EmbeddedMan/FBMiniLEDController/Board/FBMiniLEDController_v11/FBMiniLEDController_v1.1_2.jpg

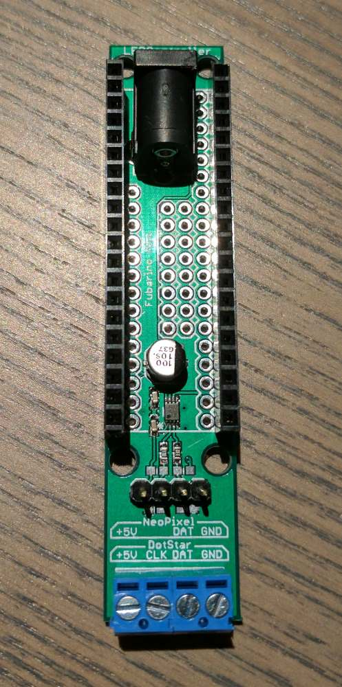
Board/FBMiniLEDController_v11/FBMiniLEDController_v1.1_2.jpg
