EmbeddedMan/FBMiniLEDController/README.md

# FBMiniLEDController
DotStar/NeoPixel controller board for Fubarino Mini chipKIT board
