EmbeddedMan/FBMiniLEDController/Board/FBMiniLEDController_v11/FBMiniLEDController_v11_BOM.xlsx

FBMiniLEDController v1.1 BOM
 |  | Lines in read are Do Not Populate!
Item # | Qty | Ref Des | Manufacturer | Mfg Part # | Dist. Part # | Description | Package | Type
1 | 2 | C1, C2 | Kemet | C0603C104K5RACTU | 399-5089-1-ND | CAP CERAMIC .100UF 50V X7R 0603 | 0603 | SMT
2 | 1 | J4 | CUI Inc. | PJ-202A | CP-202A-ND | Power Barrel Connector Jack 2.00mm ID (0.079"), 5.50mm OD (0.217") Through Hole, Right Angle | connector | through-hole
alt 2 | 1 | J4 |  |  |  | https://www.amazon.com/15PCS-Power-Socket-Barrel-Type-DC-005/dp/B00W944ACE | connector | through-hole
3 | 1 | S1 | C&K (https://www.digikey.com/en/supplier-centers/c/ck-components) | 1101M2S3AQE2 | CKN5006-ND | SWITCH SLIDE SPDT 6A 120V | switch | through-hole
alt 3 | 1 | S1 |  |  |  | https://www.aliexpress.com/store/product/SS-12D06-1P2T-handle-high-5MM-single-row-of-curved-foot-toggle-switch-10pcs-lot/2191027_32663392378.html | switch | through-hole
4 | 1 | U1 | Nexperia USA Inc. (https://www.digikey.com/en/supplier-centers/n/nexperia) | 74LVCH2T45DC,125 | 1727-4596-1-ND | TXRX TRANSLATING 3ST 8VSSOP | 8VSSOP | smt
5 | 1 | J3 | Phoenix Contact (https://www.digikey.com/en/supplier-centers/p/phoenix-contact) | 1984989 | 277-6404-ND | CONN TERM BLOCK 4POS 3.5MM | header | through-hole
6 | 1 | J7
7 | 2 | J8, J9
8 | 2 | J5, J6
9 | 2 | J1, J2 | Sullins Connector Solutions (https://www.digikey.com/en/supplier-centers/s/sullins-connector-solutions) | PPTC201LFBN-RC | S7018-ND | CONN HEADER FEMALE 20POS.1" TIN | header | through-hole
alt 9 | 2 | J1,J2 |  |  |  | https://www.amazon.com/uxcell-2-54mm-Single-Straight-Ardunio/dp/B013STKIH4
 |  |  |  |  |  | BOARD SUMMARY FOR QUOTE
 |  |  |  |  |  | Unique Part Count | 32
 |  |  |  |  |  | Total Placements | 266
 |  |  |  |  |  | Thru Hole Placements | 10
 |  |  |  |  |  | Has BGA Placements? | No
