EmbeddedMan/FBMiniLEDController/Board/FBMiniLEDController_v1/BOM.txt

Switch : EG2355-ND
  ALT: https://www.amazon.com/Gadgeter-Position-Terminal-Latching-Toggle/dp/B01JU6KBH6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
  
Level shifter : 1727-4596-1-ND
