EmbeddedMan/FBMiniLEDController/Board/FBMiniLEDController_v11/FBMiniLEDStrip_sch_v11.pdf

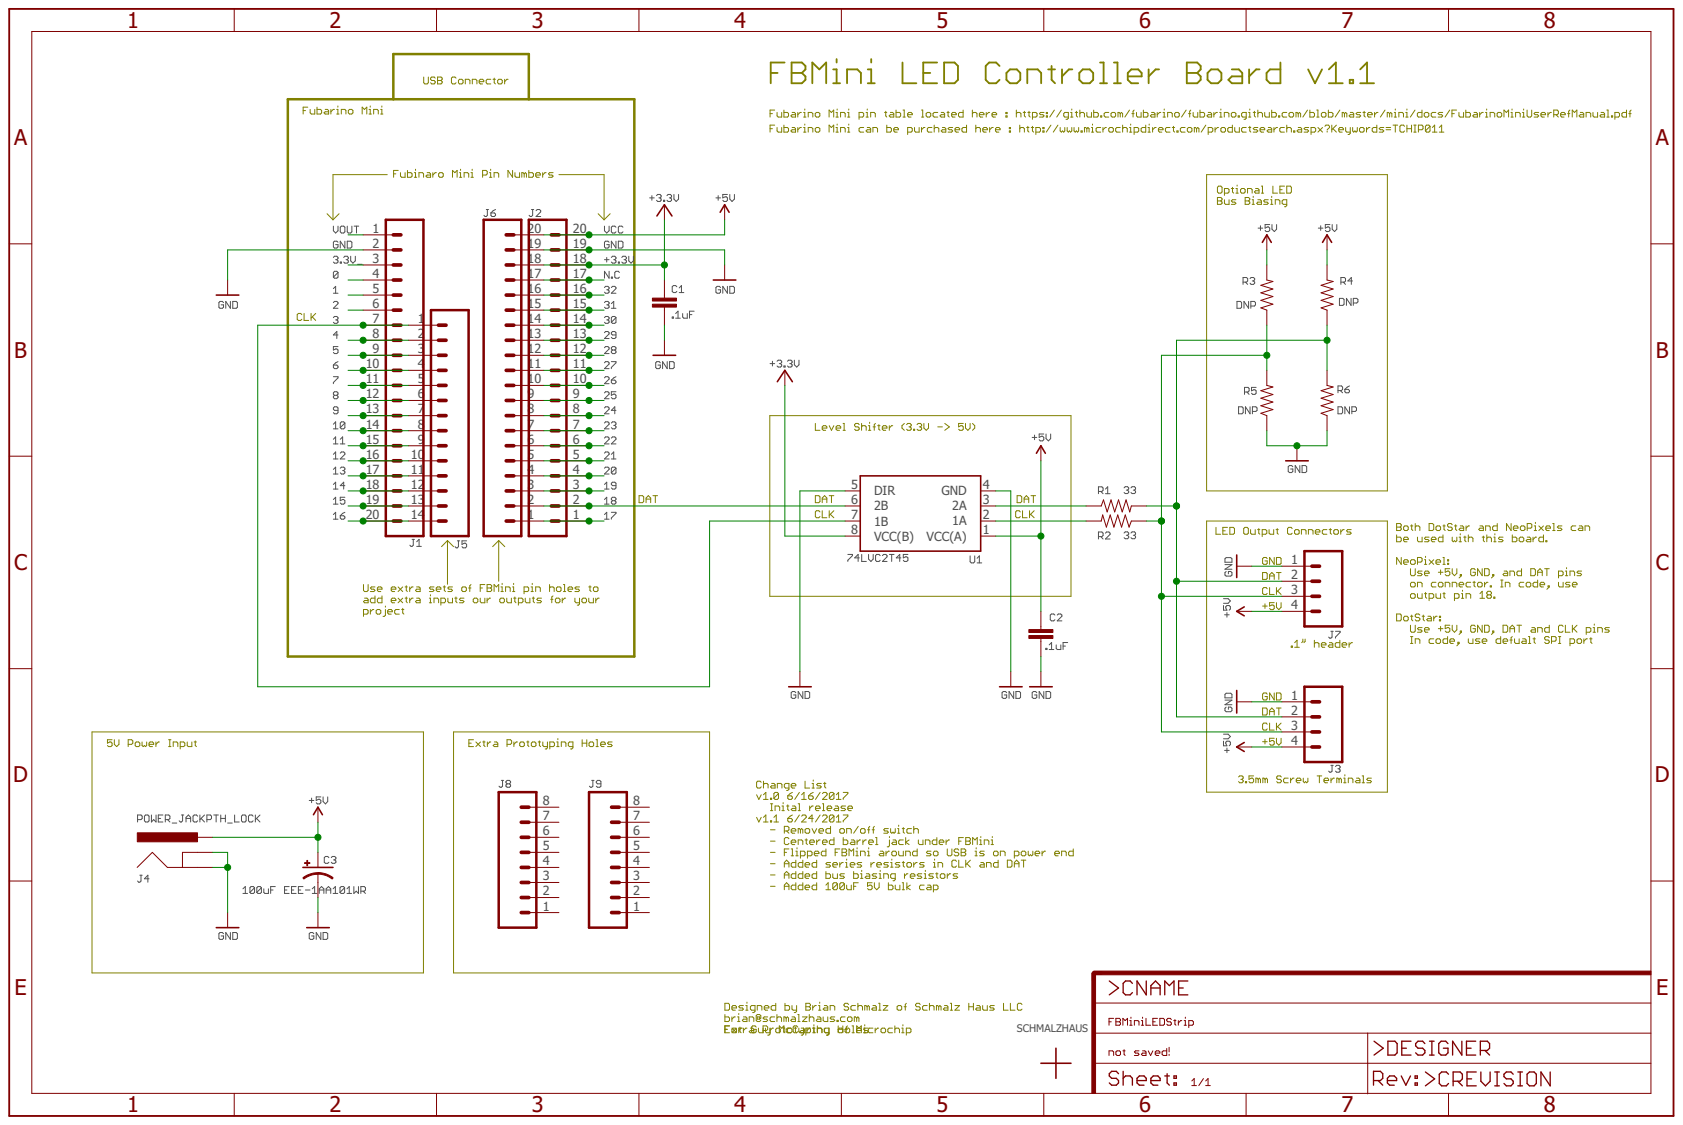
[picture p3: page 1]
