EmbeddedMan/FBMiniLEDController/Board/FBMiniLEDController_v1/FBMiniLEDStrip_brd.pdf

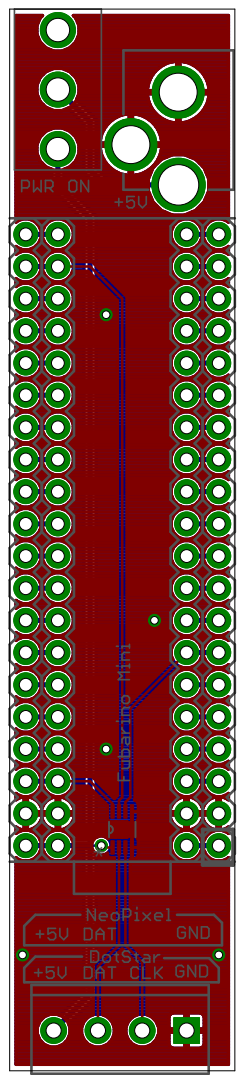
[picture p4: page 1]
