EmbeddedMan/FBMiniLEDController/Board/FBMiniLEDController_v1/FBMiniLEDStrip_sch.pdf

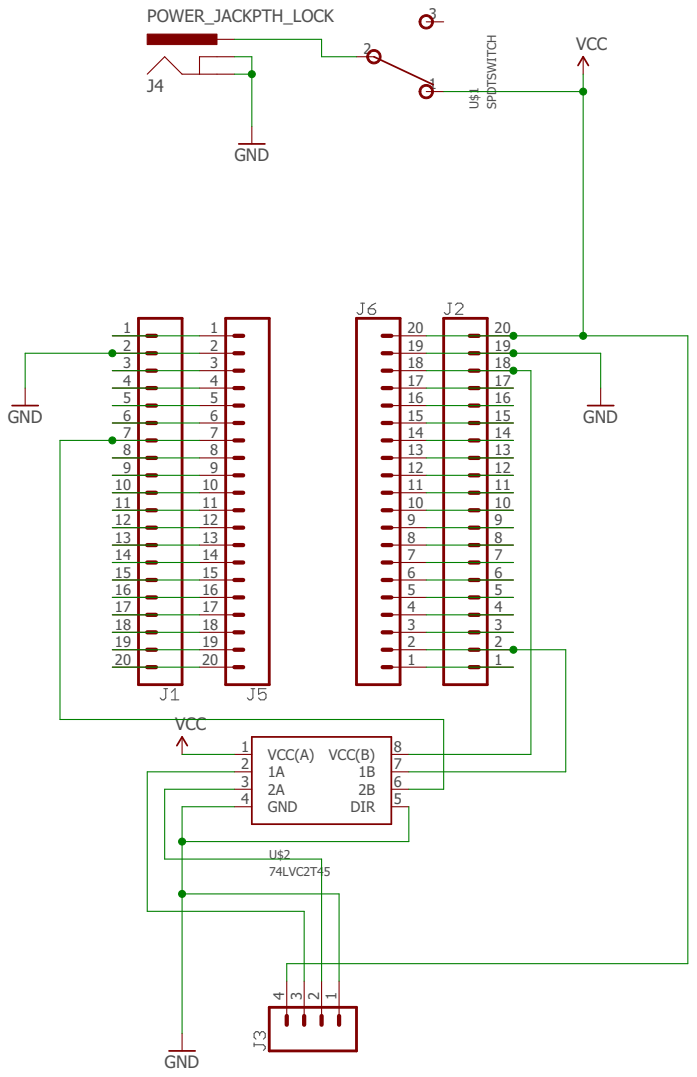
[picture p5: page 1]
