EmbeddedMan/FBMiniLEDController/Board/FBMiniLEDController_v11/FBMiniLEDStrip.brd

## EAGLE design Board/FBMiniLEDController_v11/FBMiniLEDStrip.brd (2017-07-23)

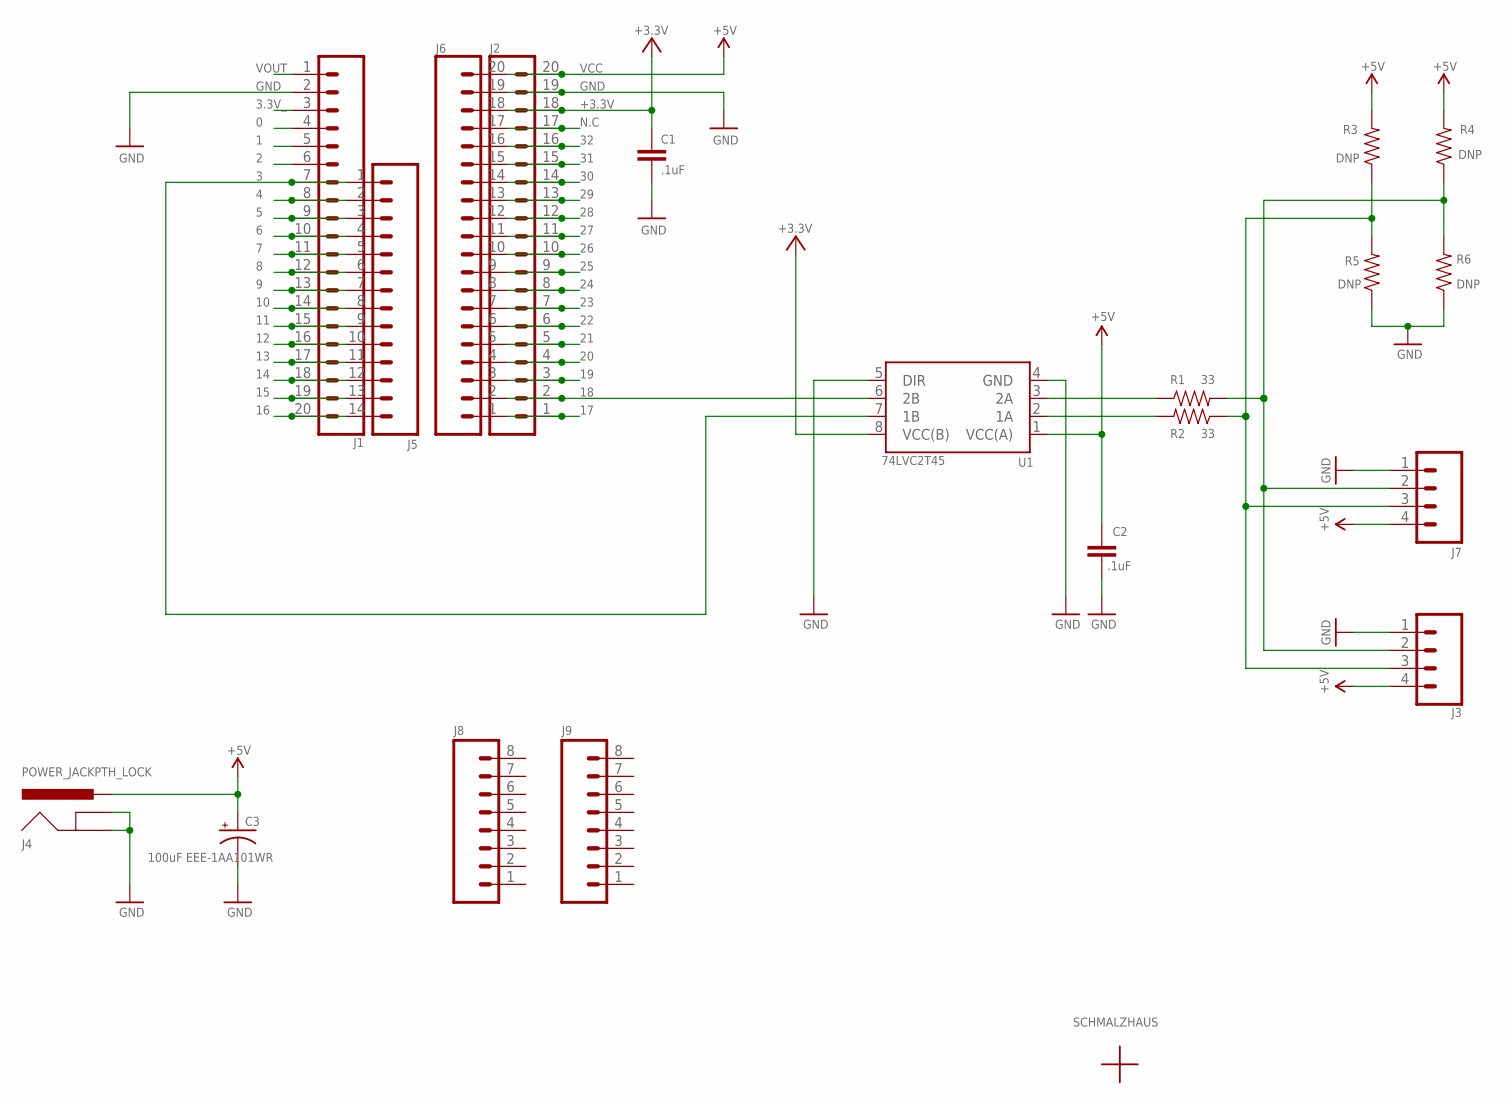
[picture p6: schematic FBMiniLEDStrip.sch]

Parts:
C1, C2: .1uF; 0603-CAP
C3: 100uF EEE-1AA101WR; PANASONIC_C
J1, J2, J6: CONN_20; 1X20
J3: CONN_04SCREW; SCREWTERMINAL-3.5MM-4@1
J4: POWER_JACKPTH_LOCK; POWER_JACK_PTH_LOCK
J5: M14; 1X14
J7: M04PTH; 1X04
J8, J9: M08; 1X08_ROUND
R1, R2: 33; 0603-RES
R3, R4, R5, R6: DNP; 0603-RES
U1: 74LVC2T45; VSSOP8
U$1: SCHMALZHAUSSCHMALZHAUS_SMALL; SCHMALZHAUS_SMALL

Connections:
0: J1.4
1: J1.5
2: J1.6
3: J1.7, J5.1, U1.7 (1B)
3.3V_: J1.3
4: J1.8, J5.2
5: J1.9, J5.3
6: J1.10, J5.4
7: J1.11, J5.5
8: J1.12, J5.6
9: J1.13, J5.7
10: J1.14, J5.8
11: J1.15, J5.9
12: J1.16, J5.10
13: J1.17, J5.11
14: J1.18, J5.12
15: J1.19, J5.13
16: J1.20, J5.14
17: J2.1, J6.1
18: J2.2, J6.2, U1.6 (2B)
19: J2.3, J6.3
20: J2.4, J6.4
21: J2.5, J6.5
22: J2.6, J6.6
23: J2.7, J6.7
24: J2.8, J6.8
25: J2.9, J6.9
26: J2.10, J6.10
27: J2.11, J6.11
28: J2.12, J6.12
29: J2.13, J6.13
30: J2.14, J6.14
31: J2.15, J6.15
32: J2.16, J6.16
+3.3V: C1.1, J2.18, J6.18
+3V3: U1.8 (VCC(B))
GND: C1.2, C2.1, C3.-, J1.2, J2.19, J3.1, J4.GND, J4.GNDBREAK, J6.19, J7.1, R5.1, R6.1, U1.4 (GND), U1.5 (DIR)
unnamed: J3.2, J7.2, R1.2, R4.1, R6.2
unnamed: R2.2, U1.2 (1A)
unnamed: J3.3, J7.3, R2.1, R3.1, R5.2
unnamed: R1.1, U1.3 (2A)
N.C: J2.17, J6.17
VCC: C2.2, C3.+, J2.20, J3.4, J4.PWR, J6.20, J7.4, R3.2, R4.2, U1.1 (VCC(A))
VOUT: J1.1

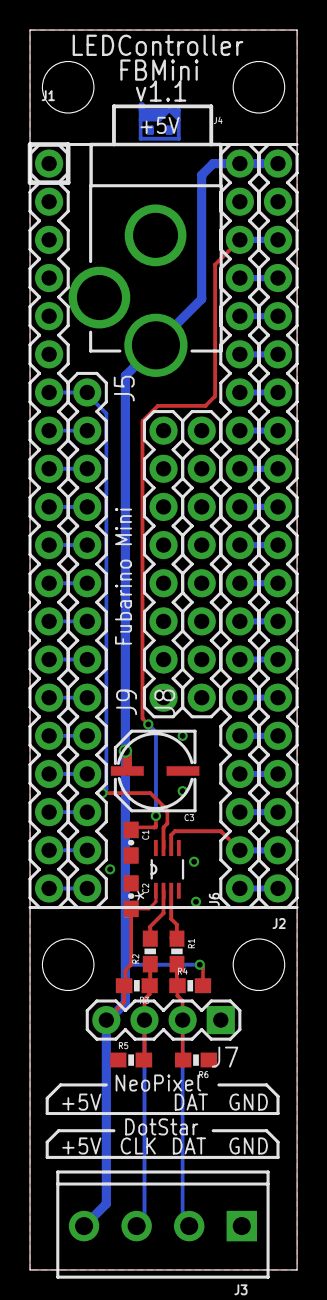
[picture p7: board FBMiniLEDStrip.brd from above]

Board: 2 copper layers, 17.8 x 82.5 mm, 20 parts (1 on the bottom side), 38 nets.
