EmbeddedMan/FBMiniLEDController/(commit log)

2017-06-17 Adding initial files.
    [FBMiniLEDController_v10_BOM.xls, FBMiniLEDController_v10_BOM.xlsx, FBMiniLEDStrip.brd, FBMiniLEDStrip.sch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]
2017-07-06 Version 1.1 of board - checked out, works great.
    [FBMiniLEDController_v11_BOM.xlsx, FBMiniLEDStrip.brd, FBMiniLEDStrip.sch]
2017-07-23 Updated v1.1 schematic with a lot more good information - no board changes.
    [FBMiniLEDStrip.brd, FBMiniLEDStrip.sch]
